magik6k/servo-sysid/sc15/rendered/charts/bang-dark.png

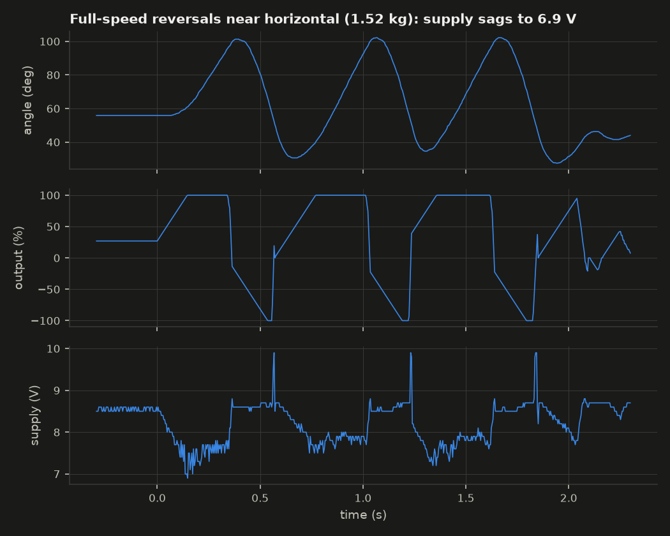
sc15/rendered/charts/bang-dark.png
