magik6k/servo-sysid/sc15/rendered/charts/friction_band-dark.png

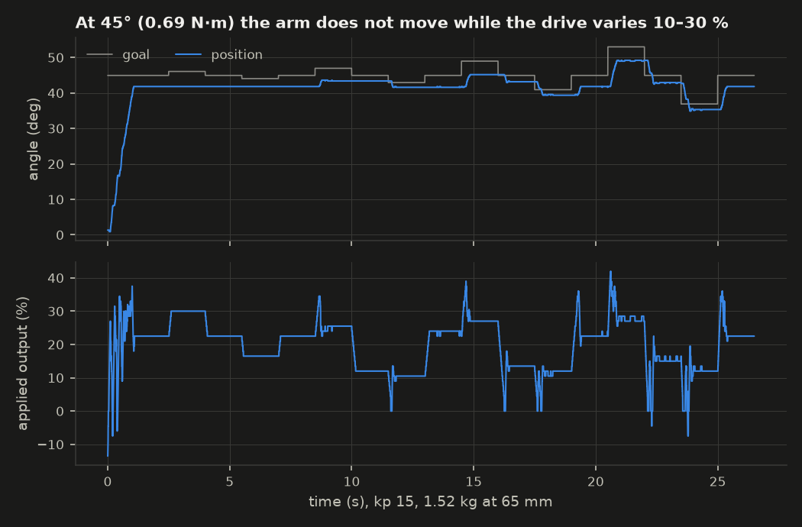
sc15/rendered/charts/friction_band-dark.png
