magik6k/servo-sysid/sc15/rendered/charts/gearbox_asymmetry-dark.png

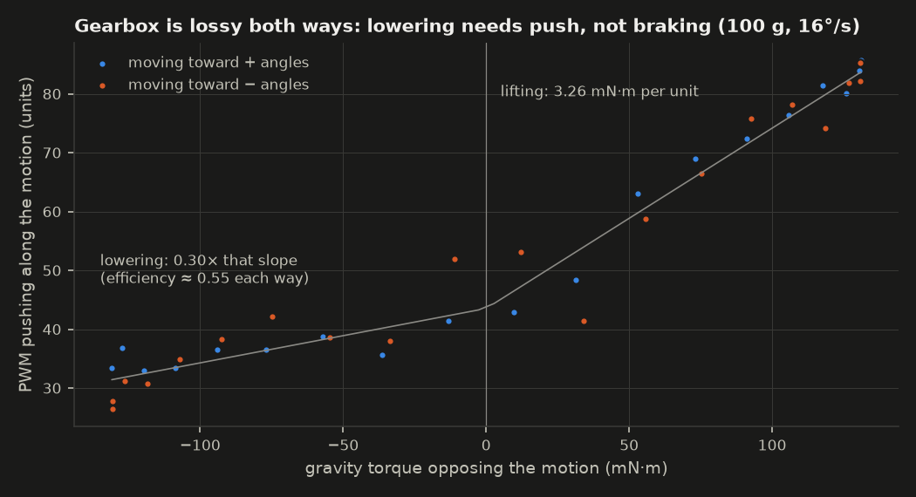
sc15/rendered/charts/gearbox_asymmetry-dark.png
