magik6k/servo-sysid/sc15/rendered/charts/heavy_release-dark.png

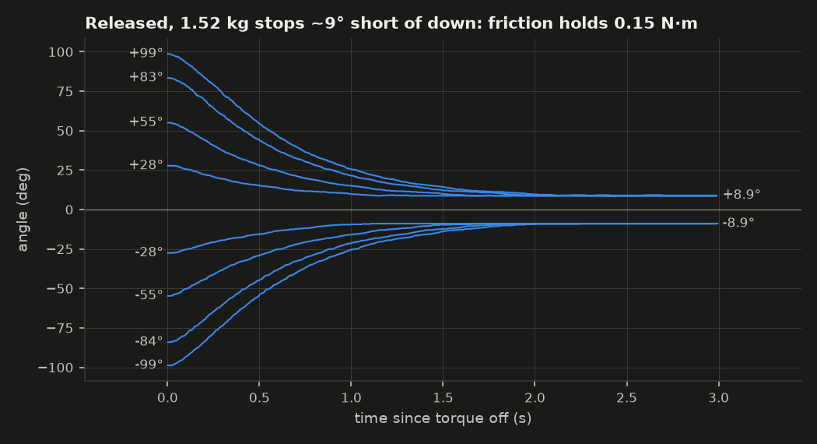
sc15/rendered/charts/heavy_release-dark.png
