magik6k/servo-sysid/sc15/rendered/charts/heavy_speed_vs_angle-dark.png

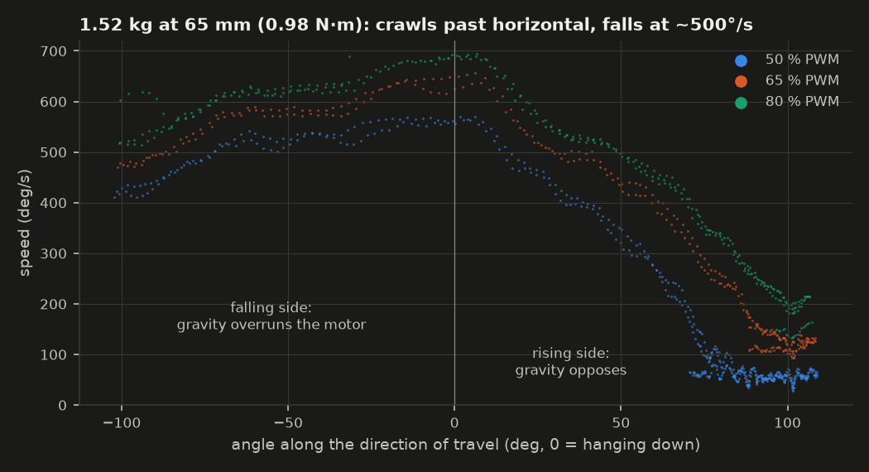
sc15/rendered/charts/heavy_speed_vs_angle-dark.png
