magik6k/servo-sysid/sc15/rendered/charts/hunting-dark.png

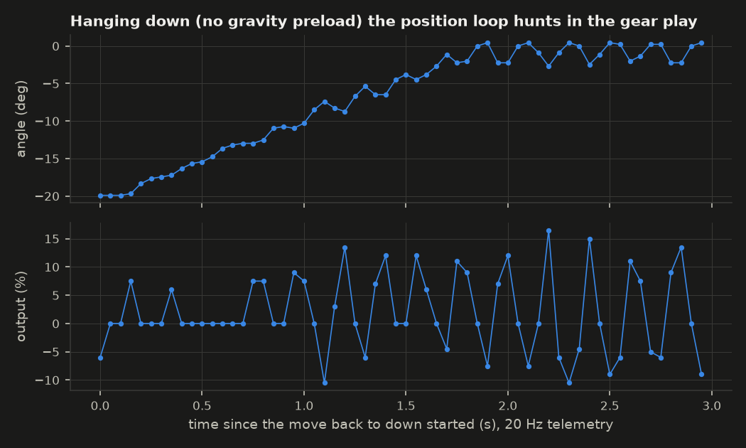
sc15/rendered/charts/hunting-dark.png
