magik6k/servo-sysid/sc15/rendered/charts/model_fit-dark.png

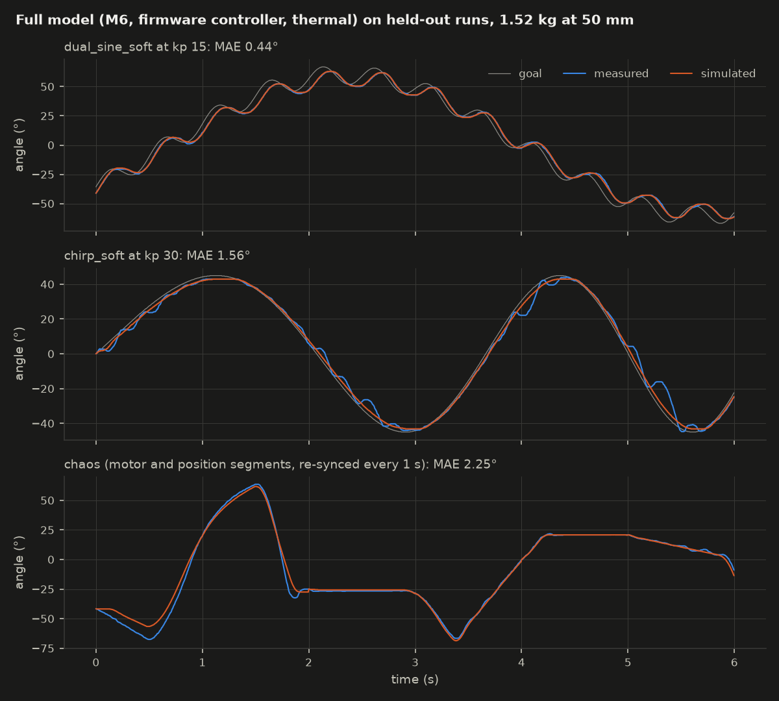
sc15/rendered/charts/model_fit-dark.png
