magik6k/servo-sysid/sc15/rendered/charts/model_mae-dark.png

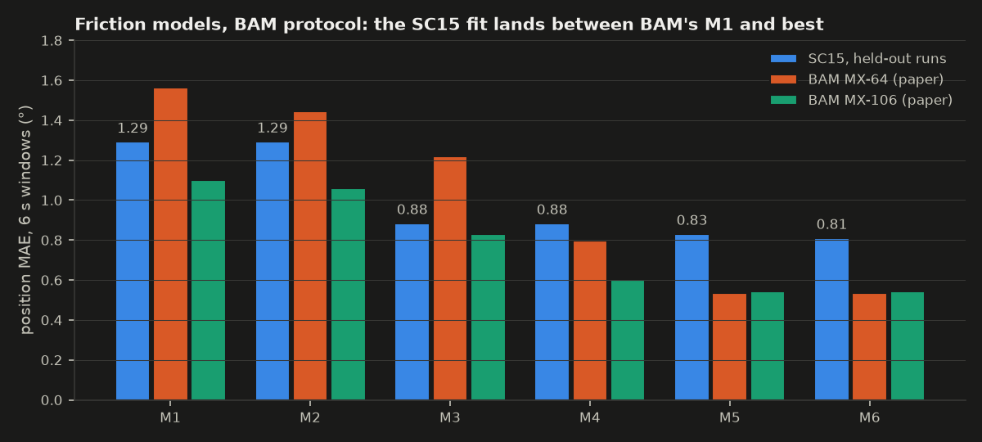
sc15/rendered/charts/model_mae-dark.png
