magik6k/servo-sysid/sc15/rendered/charts/motor_slew-dark.png

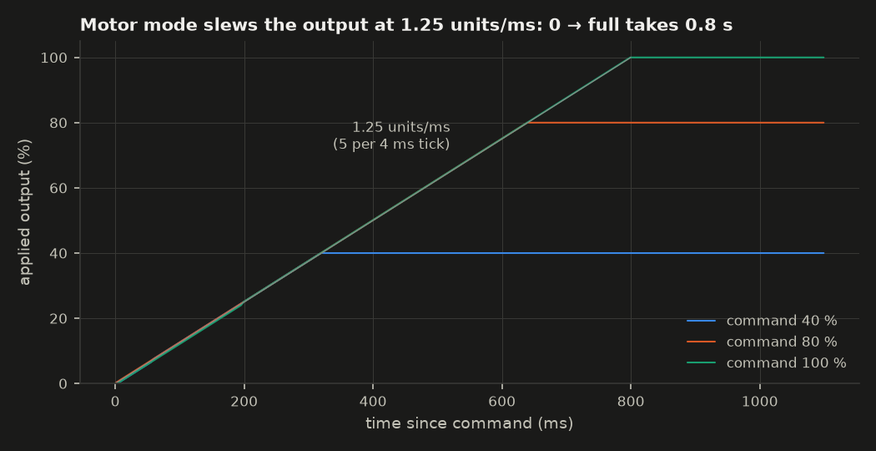
sc15/rendered/charts/motor_slew-dark.png
