magik6k/servo-sysid/sc15/rendered/charts/position_law-dark.png

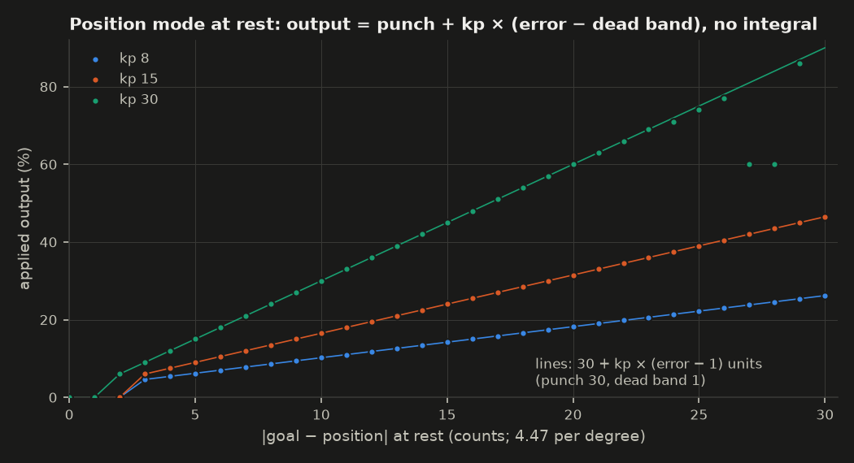
sc15/rendered/charts/position_law-dark.png
