magik6k/servo-sysid/sc15/rendered/charts/position_slew-dark.png

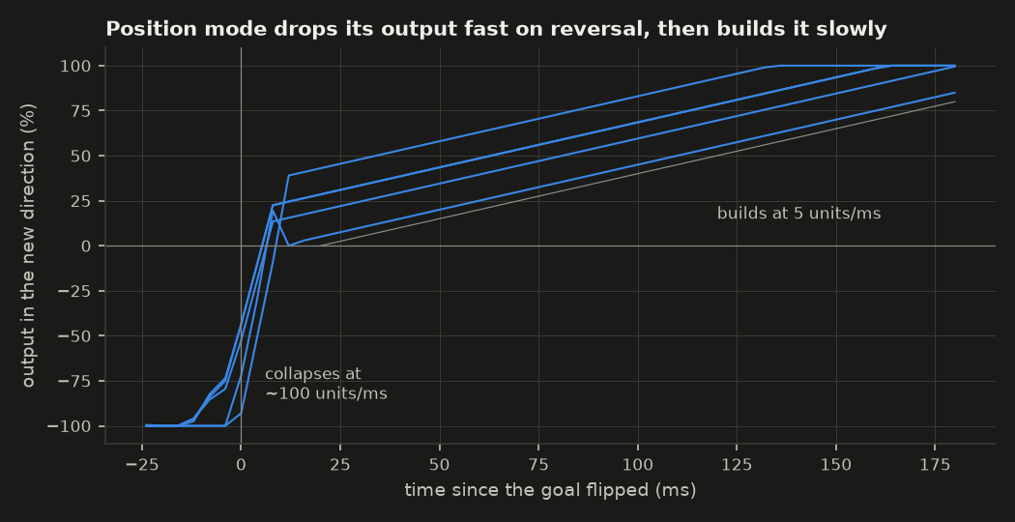
sc15/rendered/charts/position_slew-dark.png
