magik6k/servo-sysid/sc15/rendered/charts/probes-dark.png

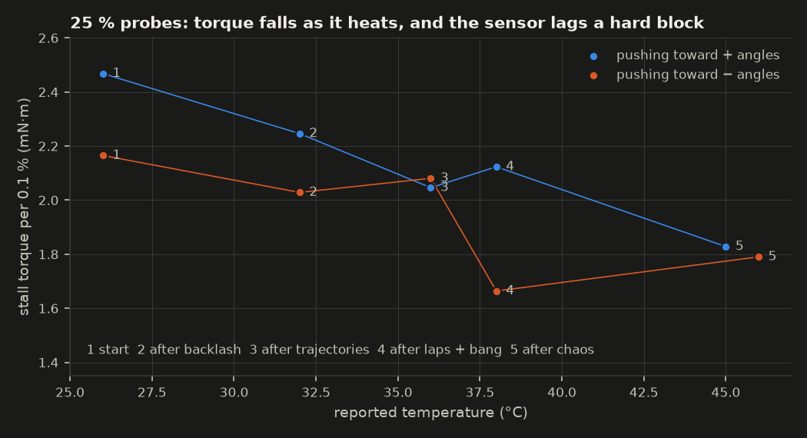
sc15/rendered/charts/probes-dark.png
