magik6k/servo-sysid/sc15/rendered/charts/regen_clamp-dark.png

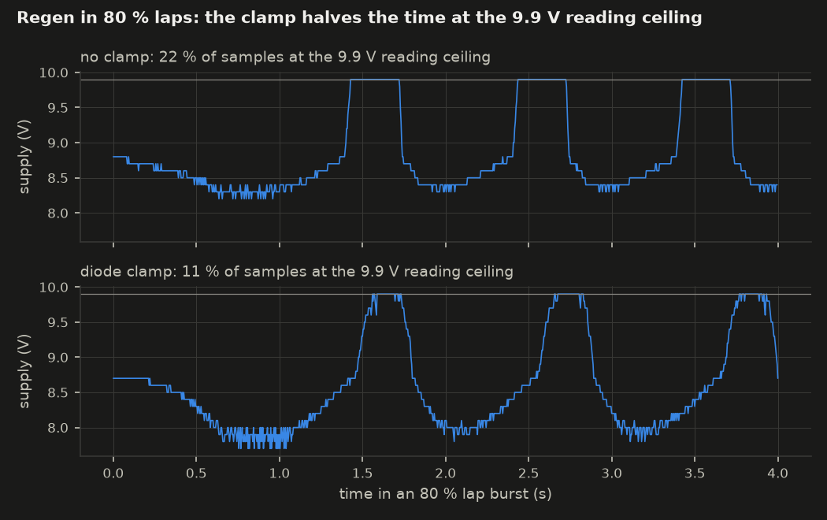
sc15/rendered/charts/regen_clamp-dark.png
