magik6k/servo-sysid/sc15/rendered/charts/sensor_window-dark.png

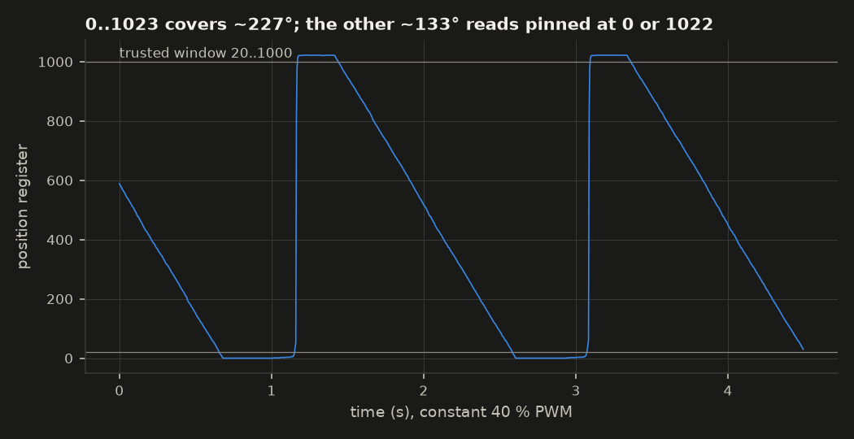
sc15/rendered/charts/sensor_window-dark.png
