magik6k/servo-sysid/sc15/rendered/charts/speed_register-dark.png

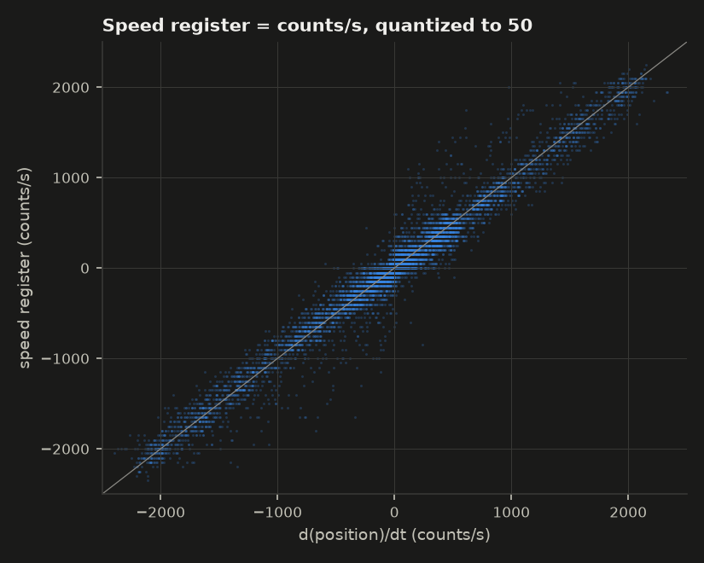
sc15/rendered/charts/speed_register-dark.png
