magik6k/servo-sysid/sc15/rendered/charts/speed_vs_pwm-dark.png

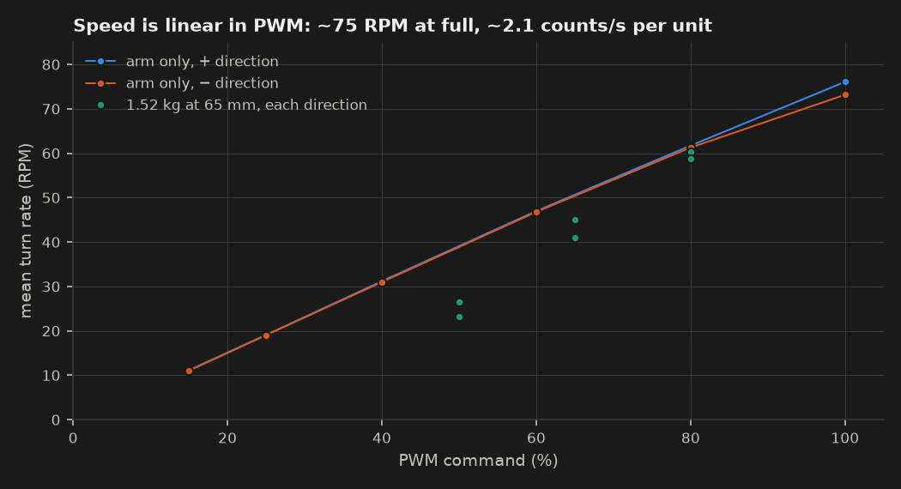
sc15/rendered/charts/speed_vs_pwm-dark.png
