magik6k/servo-sysid/sc15/rendered/charts/static_hold-dark.png

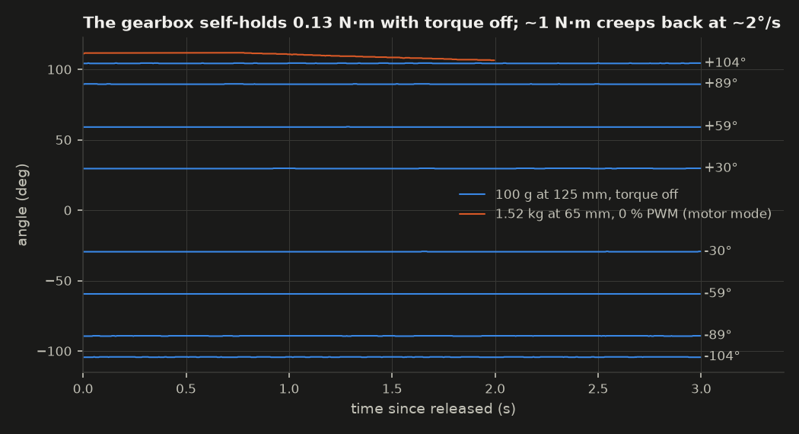
sc15/rendered/charts/static_hold-dark.png
