magik6k/servo-sysid/sc15/rendered/charts/temperature-dark.png

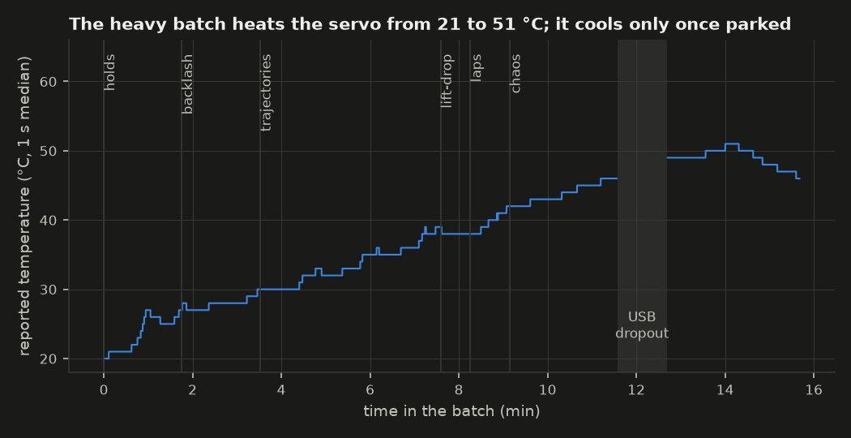
sc15/rendered/charts/temperature-dark.png
