magik6k/servo-sysid/sc15/rendered/charts/thermal_derating-dark.png

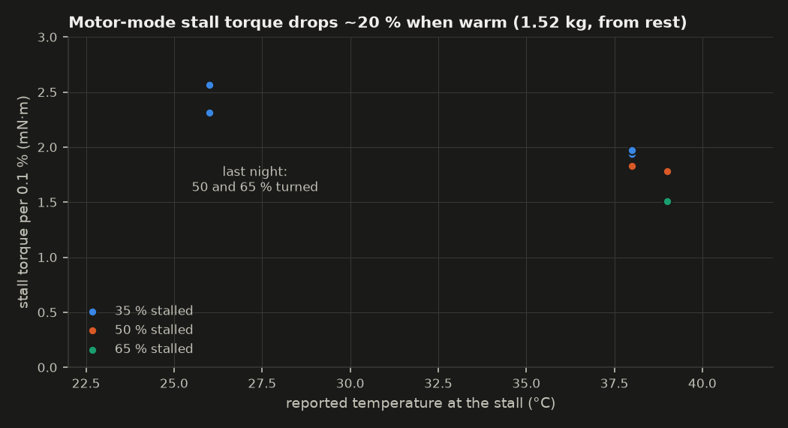
sc15/rendered/charts/thermal_derating-dark.png
