magik6k/servo-sysid/sc15/rendered/charts/torque_per_pwm-dark.png

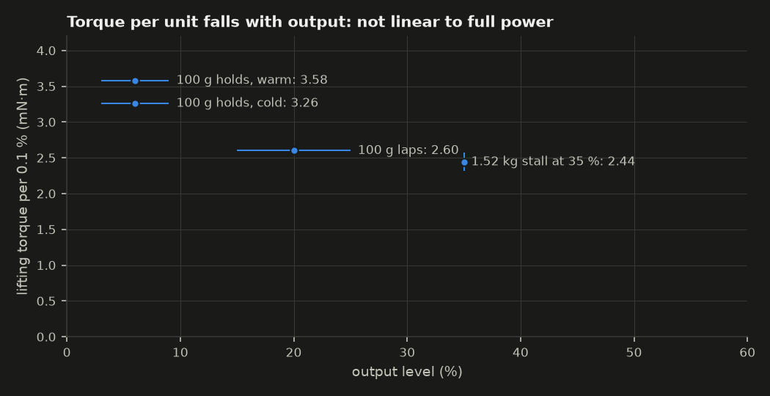
sc15/rendered/charts/torque_per_pwm-dark.png
