magik6k/servo-sysid/sc15/rendered/charts/voltage_scaling-dark.png

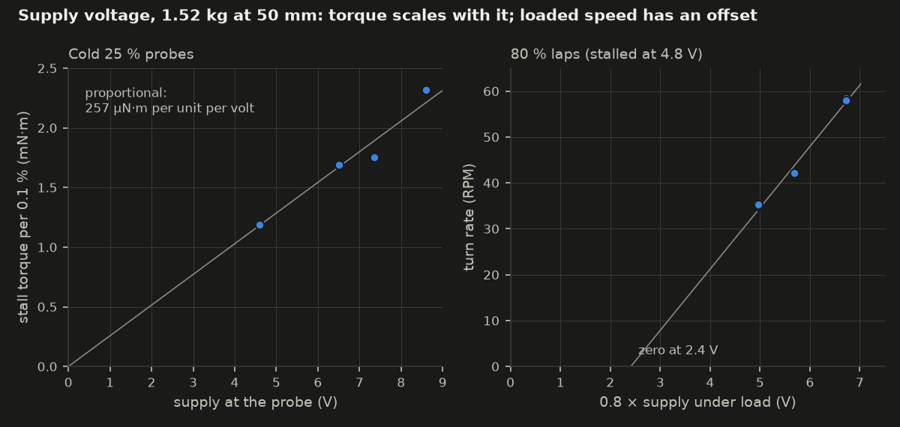
sc15/rendered/charts/voltage_scaling-dark.png
