magik6k/servo-sysid/shared/rig/stl/view_iso.png

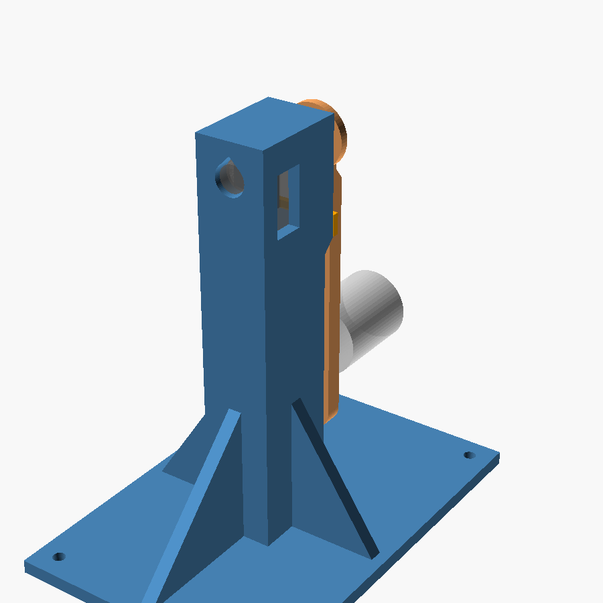
shared/rig/stl/view_iso.png
