magik6k/servo-sysid/shared/rig/stl/view_side.png

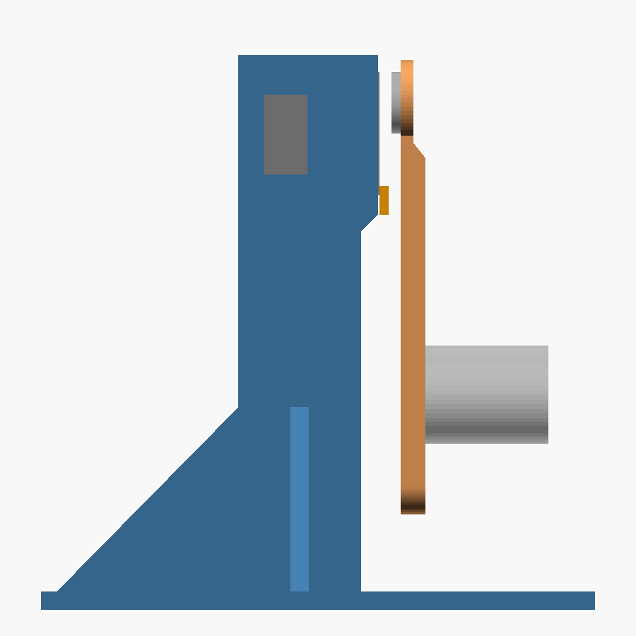
shared/rig/stl/view_side.png
