magik6k/servo-sysid/shared/rig/stl/stand.3mf

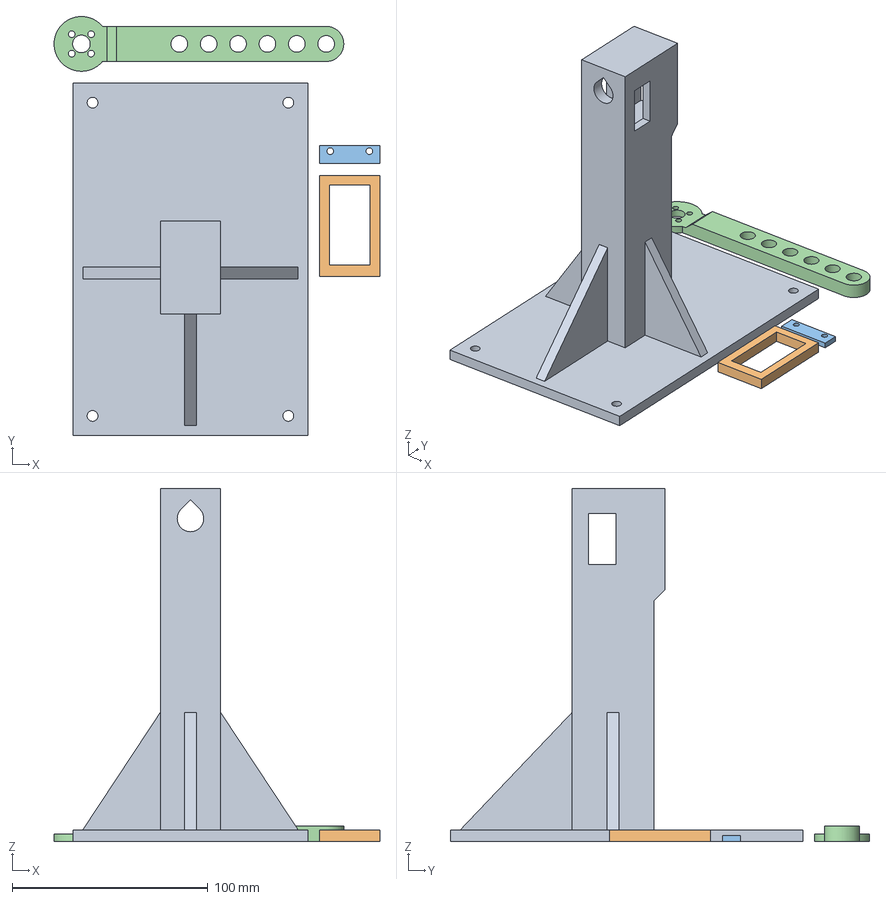
[picture p46: CAD file, 2026-10-30]
shared/rig/stl/stand.3mf
166.5 x 214.0 x 180.4 mm
stand.stl
fit_test.stl
retainer.stl
arm.stl
