magik6k/servo-sysid/shared/rig/stl/arm.stl

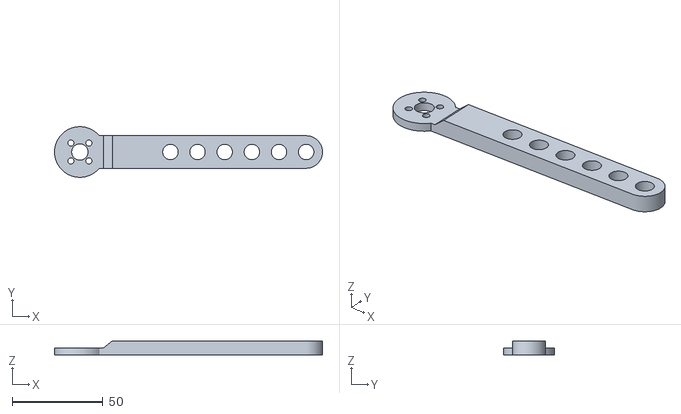
[picture p47: CAD file, 2026-10-30]
shared/rig/stl/arm.stl
148.0 x 28.0 x 8.00
