magik6k/servo-sysid/shared/rig/stl/spool_clamp.stl

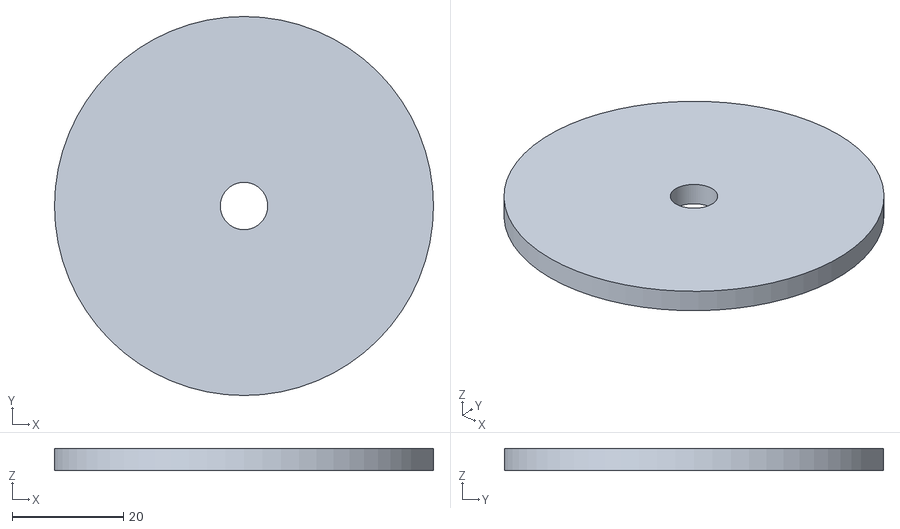
[picture p48: CAD file, 2026-10-30]
shared/rig/stl/spool_clamp.stl
68.0 x 68.0 x 4.00
