magik6k/servo-sysid/shared/rig/stl/heavy_arm.stl

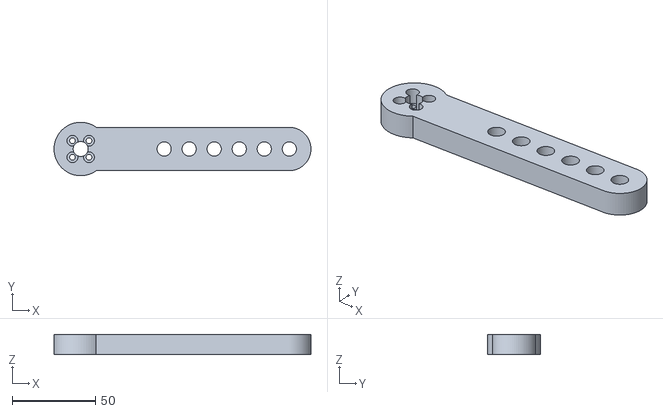
[picture p49: CAD file, 2026-10-30]
shared/rig/stl/heavy_arm.stl
154.0 x 32.0 x 12.0
