magik6k/servo-sysid/shared/rig/stl/spool_hub.stl

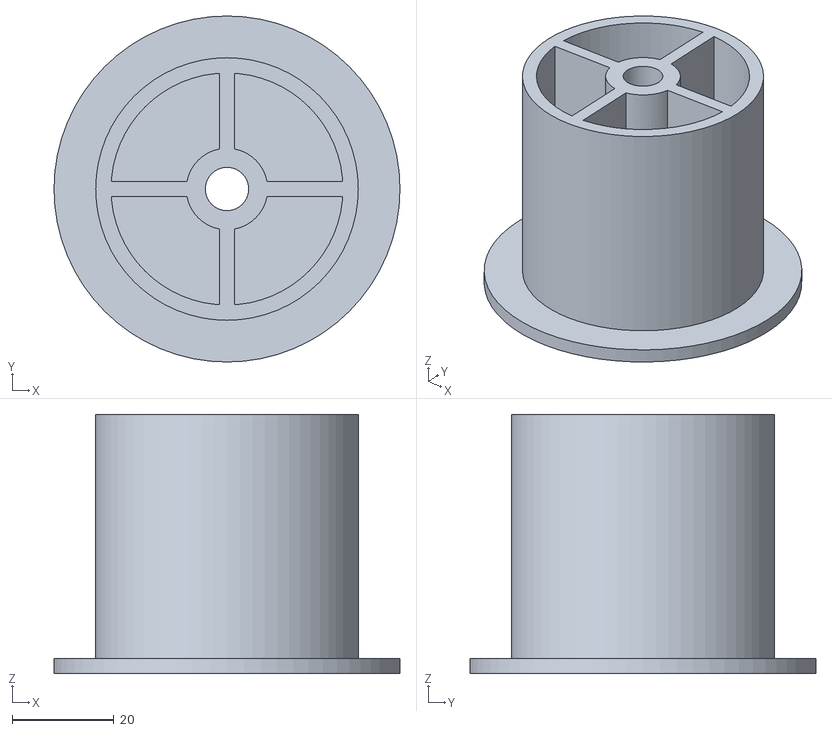
[picture p50: CAD file, 2026-10-30]
shared/rig/stl/spool_hub.stl
68.0 x 68.0 x 51.0
