magik6k/servo-sysid/shared/rig/stl/fit_test.stl

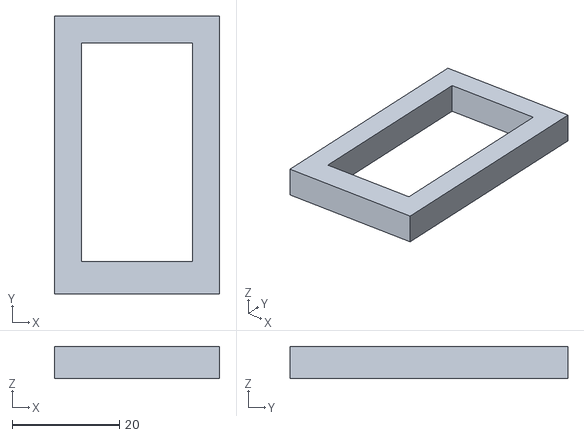
[picture p51: CAD file, 2026-10-30]
shared/rig/stl/fit_test.stl
30.8 x 51.8 x 6.00
