magik6k/servo-sysid/shared/rig/stl/retainer.stl

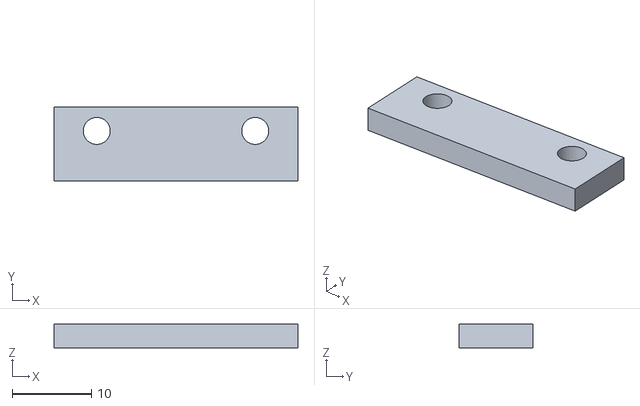
[picture p52: CAD file, 2026-10-30]
shared/rig/stl/retainer.stl
30.8 x 9.30 x 3.00
