magik6k/servo-sysid/(list of files, cad)

Other CAD files:
shared/rig/stl/stand.stl
