magik6k/servo-sysid/sc15/rendered/charts/step_response-dark.png

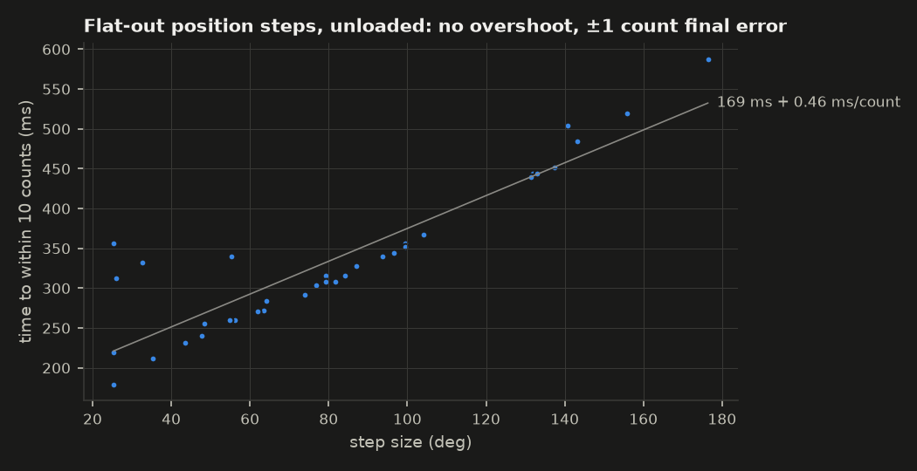
sc15/rendered/charts/step_response-dark.png
