magik6k/servo-sysid/shared/rig/stl/assembly.png

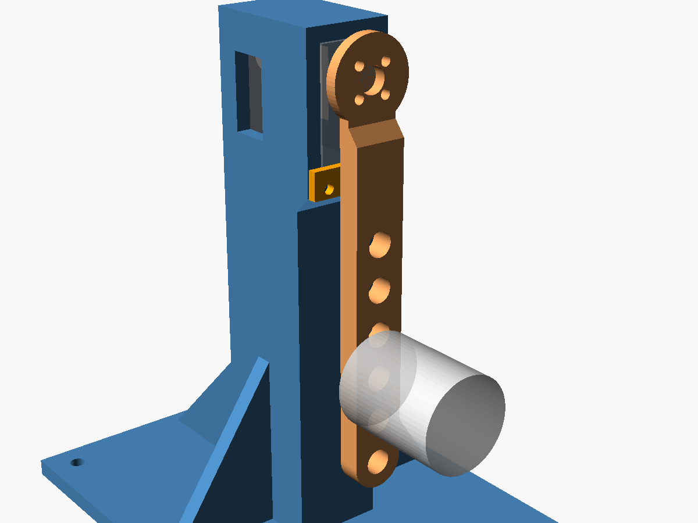
shared/rig/stl/assembly.png
