magik6k/servo-sysid/(commit log)

2026-10-30 SC15 bench characterisation: firmware, tools, rig, data, charts
    Everything measured on SC15 unit 1 so far (2026-10-28..30): unloaded,
    arm-only, 100 g and 1.52 kg pendulum runs as gzipped CSV + metadata,
    the ESP32 test firmware (with the full heavy batch plan selected for
    the next run), recording/analysis tools, the OpenSCAD rig, a write-up
    of every finding, and rendered characteristic charts.
    [arm.stl, fit_test.stl, heavy_arm.stl, pendulum_rig.scad, retainer.stl, servo.json, spool_clamp.stl, spool_hub.stl]
2026-10-30 SC15: hot runs, model fit, publication prep
    - Data: 8.7 V repeat, burn, burn_high and two hot batches; the last two
    end with the stripped output gear. data/runs.csv flags unit state and
    the last trusted time per run.
    - Model: firmware controller identified (output law, D on the delayed
    speed register, slews, goal ramp); BAM M1-M6 fits plus thermal.
    Validation 0.81 deg (0.0141 rad) under the BAM protocol.
    - Firmware: burn, burn_high and heat blocks, dead-drive detection,
    START_BLOCK; plan back to HEAVY_BATCH_PROBED.
    - chaos_log: reconnects after USB dropouts, stops cleanly on SIGTERM.
    - Dual MIT/Apache-2.0 license; vendor CAD untracked (not ours to relicense).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
    [servo.json]
